misencan/Flextend/README_HARDWARE.md

# Flextend: Hardware Report

Senior Design Project: Knee Flexion and Extension Electrical Device
Boston University Department of Electrical and Computer Engineering
Authors: Sohaib Ansari, Murat Sencan

## Project Description
An electrical device that straps onto a user's leg and measures the knee joint extension and flexion angles. 

## Vendor Information and Bill of materials

### Bill of Materials For One Flextend Device

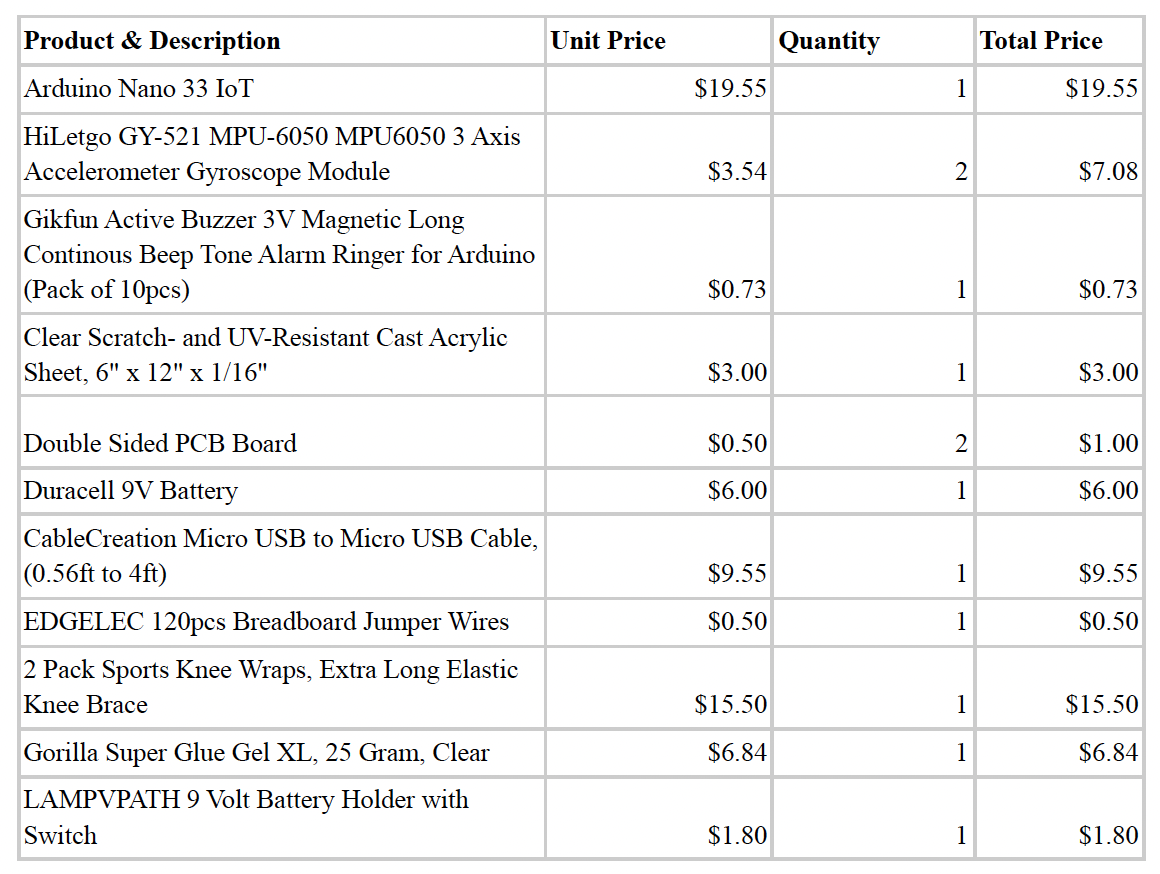
[picture p1: images/bill.png]
Bill of materials


Total cost of materials for one Flextend device is estimated at $71.55

### Vendor Information 

Product and Description | Vendor |  Link |
| --- | ----------- |  --- |
| Arduino Nano 33 IoT | Arduino | [link](https://store-usa.arduino.cc/products/arduino-nano-33-iot1) |
| HiLetgo GY-521 MPU-6050 MPU6050 3 Axis Accelerometer Gyroscope Module| Amazon (HiLetgo) |  [link](https://www.amazon.com/HiLetgo-MPU-6050-Accelerometer-Gyroscope-Converter/dp/B00LP25V1A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)  |
|Gikfun Active Buzzer 3V Magnetic Long Continous Beep Tone Alarm Ringer for Arduino (Pack of 10pcs) | Amazon (Gikfun) |  [link](https://www.amazon.com/Gikfun-Active-Magnetic-Continous-Arduino/dp/B01FVZQ6F6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)  |
|Clear Scratch- and UV-Resistant Cast Acrylic Sheet, 6" x 12" x 1/16" | McMaster-Carr |  [link](https://www.mcmaster.com/8560K178/)  |
|Double Sided PCB Board | Amazon |  [link](https://www.amazon.com/dp/B07TVHQQ7X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)  |
|Duracell 9V Battery  | Amazon (Duracell) |  [link](https://www.amazon.com/Duracell-Batteries-9Volt-size-battery/dp/B00009V2QT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)  |
|CableCreation Micro USB to Micro USB Cable, (0.56ft to 4ft) | Amazon (CableCreation) |  [link](https://www.amazon.com/CableCreation-Charging-Compatible-Android-Smartphone/dp/B075GMNY1Y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)  |
|EDGELEC 120pcs Breadboard Jumper Wires | Amazon (Edgelec) |  [link](https://www.amazon.com/EDGELEC-Breadboard-Optional-Assorted-Multicolored/dp/B07GD2BWPY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)  |
|2 Pack Sports Knee Wraps, Extra Long Elastic Knee Brace | Amazon |  [link](https://www.amazon.com/Compression-Training-Weightlifting-Powerlifting-All-Purpose/dp/B088K6RPB5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)  |
| Gorilla Super Glue Gel XL, 25 Gram, Clear | Amazon (Gorilla) |  [link](https://www.amazon.com/Gorilla-Super-Glue-gram-Clear/dp/B082XGL21J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)  |
| LAMPVPATH 9 Volt Battery Holder with Switch | Amazon (LampVPath) |  [link](https://www.amazon.com/LAMPVPATH-Pack-Battery-Holder-Switch/dp/B07BXBS93X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)  |

## Power Requirements

The HiLetgo GY-521 MPU-6050 gyroscopes require an optimal of 3.3V to function. Minimum voltage to function is 2.375V and maximum supply is 3.46V. Since the Arduino Nano has a builtin +3.3V power supply, we are able to connect both gyroscopes to this output. Operating current of MPU6050 gyroscopes are 3.9mA if all specifications are used at the same time. However, Flextend device only requires the accelerometer data which has a normal operating current of 500µA. Gyroscopes are also able to function in any temperature range of -40 to +85 Celcius. The buzzer in the circuit requires an input voltage of 2-3.5V and has an operating current less than 25mA. The buzzer has a frequency of 2300 +/-500Hz.

Arduino Nano 33 can has an operating voltage of 3.3V and maximum of 21V power input. In our case we are using 9V with impedance of 3,050 m-ohm@1kHz. Given the specifications of the Arduino and its power consumption, it is estimated that 9V battery will support the device about 20 to 30 hours. Since on time use of the device is less than 5 minutes on average, it is safe to estimate that device can be used for a minimum of 300 runs before it requires a battery change. 

## Significant Data Sheets and Sources 
- [MPU6050 Datasheet](http://www.haoyuelectronics.com/Attachment/GY-521/mpu6050.pdf)
- [Connecting Multiple Gyroscopes](https://forum.arduino.cc/t/how-to-connect-two-mpu6050/116477)
- [Angle Calculation Code](https://how2electronics.com/measure-tilt-angle-mpu6050-arduino/)
- [Arduino Nano 33 IoT Datasheet](https://docs.arduino.cc/resources/datasheets/ABX00027-datasheet.pdf)

## System Schematic 

schematic

## Enclosure Pictures 

enclosure 1

enclosure 2

## Status of the Project and Design Development 

Feb 27, 2022
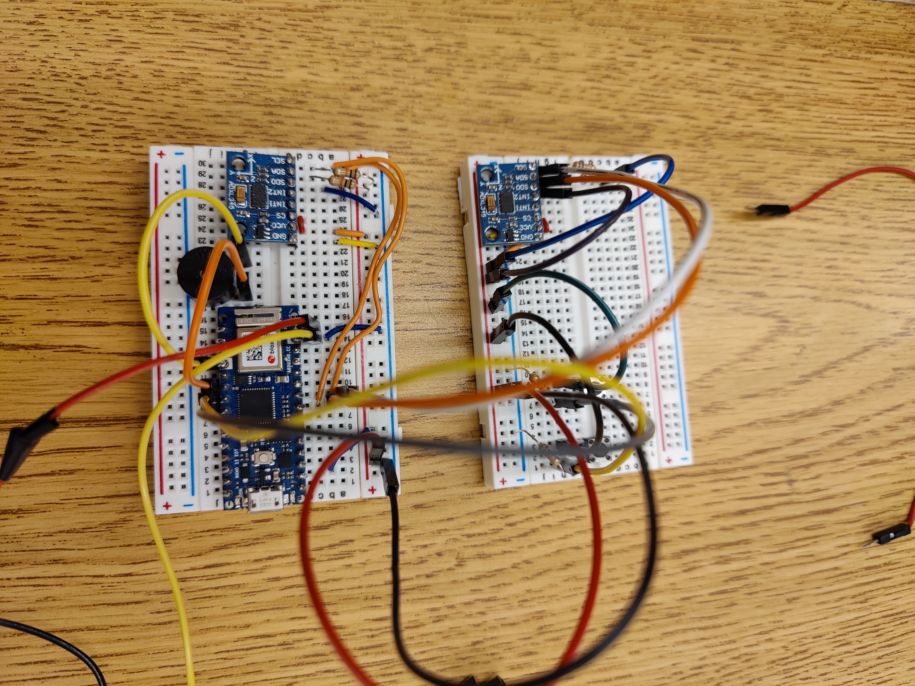
[picture p2: images/feb27.jpg]
feb27


March 15, 2022
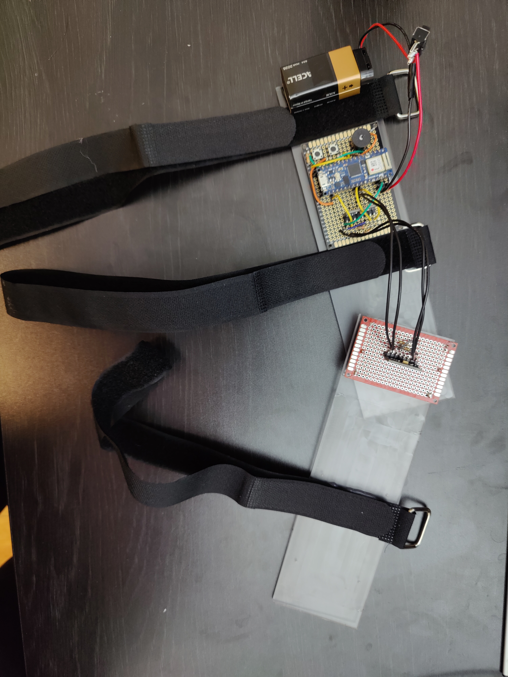
[picture p3: images/mar15.jpg]
march15


April 14, 2022
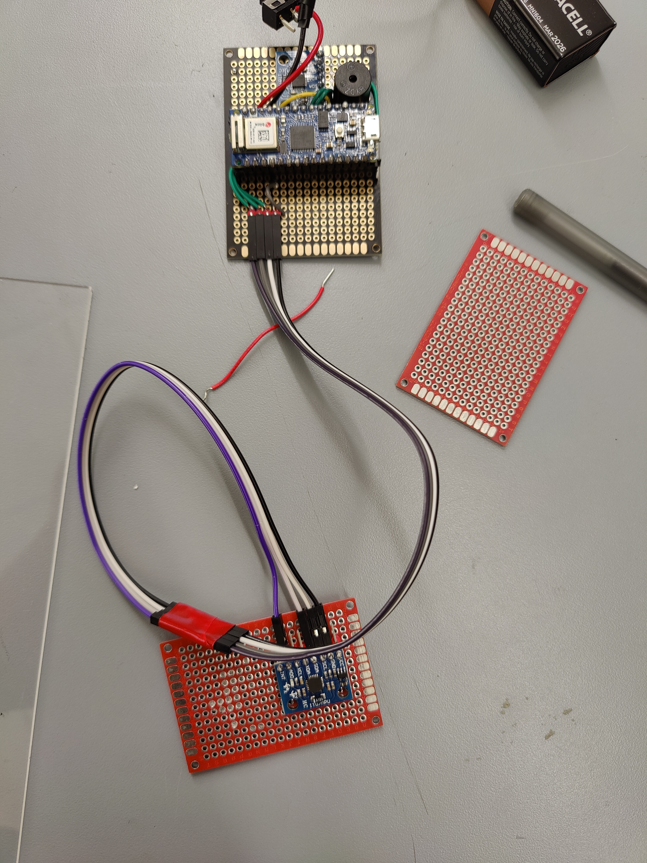
[picture p4: images/apr14-1.jpg]


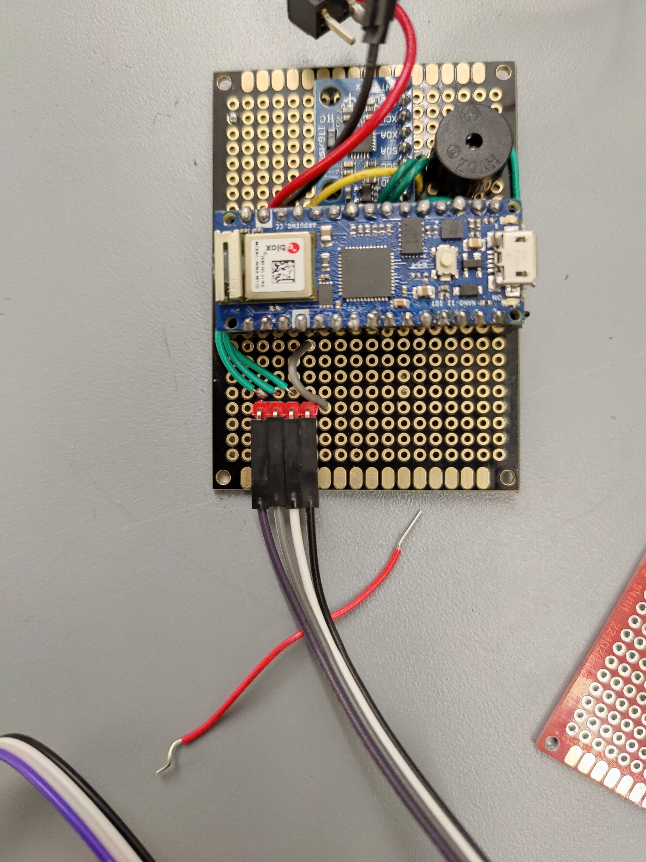
[picture p5: images/apr14-2.jpg]


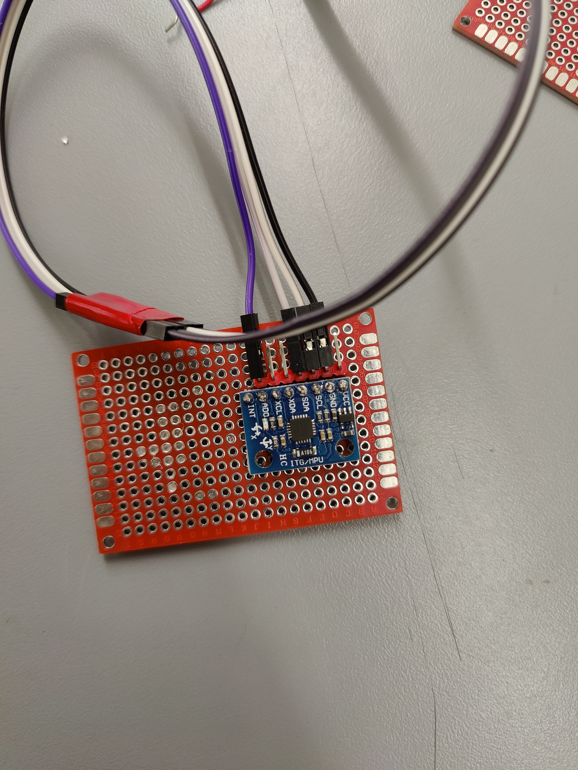
[picture p6: images/apr14-3.jpg]


April 19, 2022
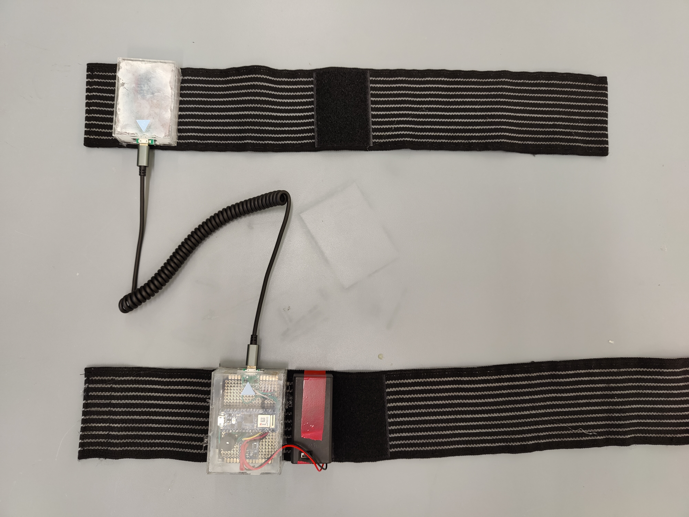
[picture p7: images/apr19.jpg]
apr19
