misencan/Flextend/images/home-background.png

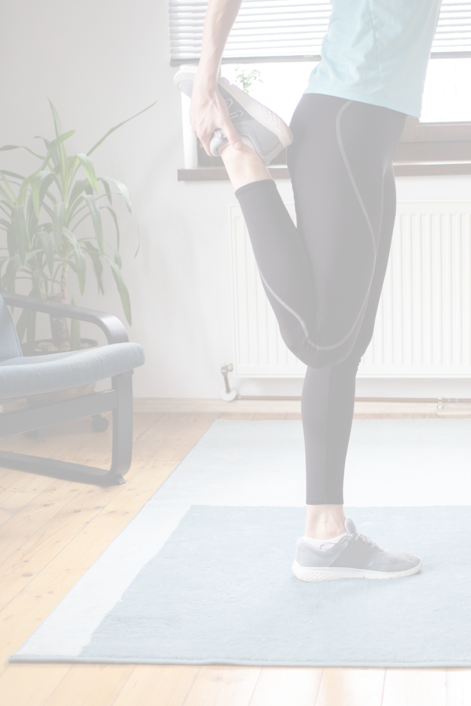
images/home-background.png
