misencan/Flextend/images/home_image.jpg

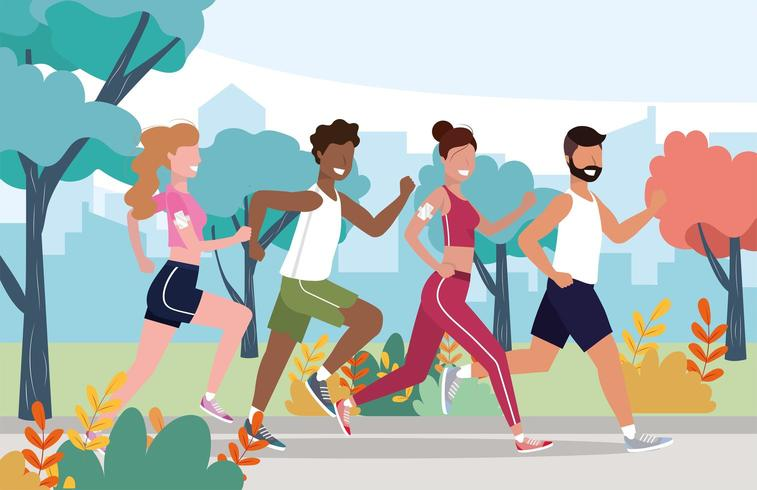
images/home_image.jpg
