misencan/Flextend/images/home_image_1.jpeg

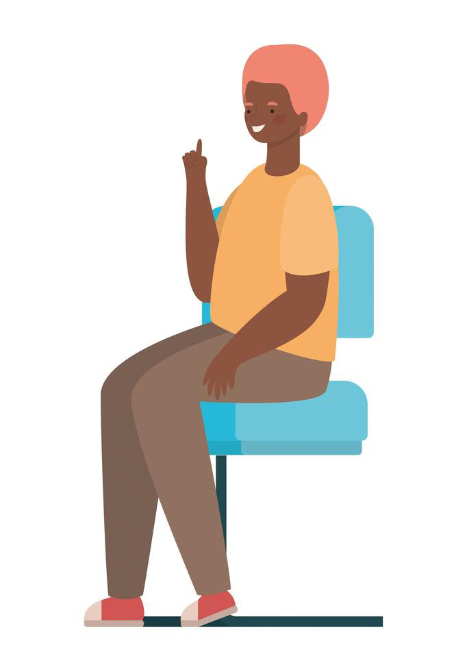
images/home_image_1.jpeg
